rolly46/rust/playdate-wall-mount/playdate_flush_dock.3mf

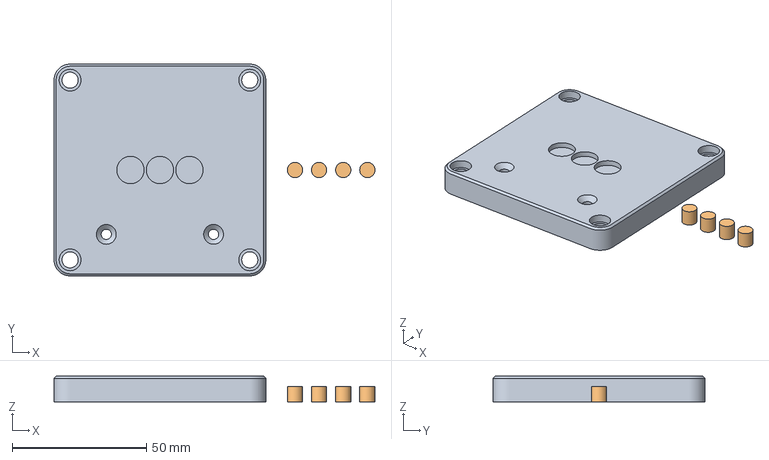
[picture p2: CAD file, 2026-10-04]
playdate-wall-mount/playdate_flush_dock.3mf
119.7 x 79.0 x 9.60 mm
Playdate wall dock plate
Contact pins
