rolly46/rust/playdate-wall-mount/playdate_contact_pins.stl

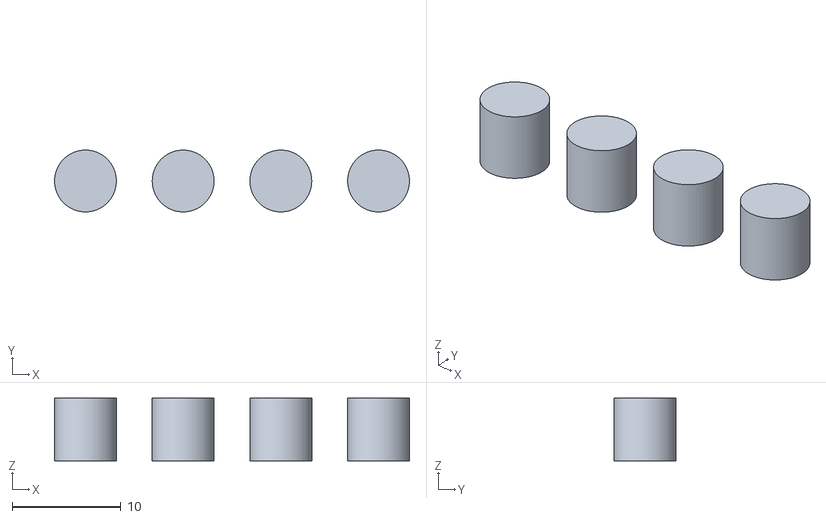
[picture p3: CAD file, 2026-10-04]
playdate-wall-mount/playdate_contact_pins.stl
32.7 x 5.70 x 5.80
