rolly46/rust/(list of files, cad)

Other CAD files:
playdate-wall-mount/playdate_flush_dock.stl
