rolly46/rust/(commit log)

2026-10-03 Add wall bracket for the Playdate magnetic charging dock
    Parametric OpenSCAD part that replaces the angled desk foot of MakerWorld
    model 1635754 so the dock hangs on a wall. It reuses the dock's alignment
    pegs and cable nut, routes the cable down through the bracket, hangs on two
    keyhole screws, and adds an optional ledge to catch the Playdate.
    Claude-Session: https://claude.ai/code/session_018FJy8db1WNSYvoHae4cP46
    [playdate_wall_bracket.scad, playdate_wall_bracket.stl]
2026-10-03 Drop the ledge from the Playdate wall bracket by default
    The bracket now sits flush behind the dock with nothing sticking out at
    the bottom. The ledge is still available with ledge = true.
    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
    [playdate_wall_bracket.scad, playdate_wall_bracket.stl]
2026-10-04 Replace the wall bracket with a flush one-piece dock plate
    The dock is now a single 4.4 mm plate that screws flat to the wall. Four
    8 x 3 mm magnets sit flush in the front; the USB cable comes through a
    hole in the wall behind the centre, and its power wires run in grooves on
    the flat back to the magnets, clamped there when the plate is screwed
    down. Two countersunk screws, hidden by the docked Playdate, hold it.
    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
    [playdate_flush_dock.scad, playdate_flush_dock.stl, playdate_wall_bracket.scad, playdate_wall_bracket.stl]
2026-10-04 Add a USB-C board compartment to the flush Playdate dock
    The back of the plate now has a bay for a USB-C 5 V breakout board and a
    channel for the cable's plug, which lies flat against the wall with the
    cable turning into the wall hole at the centre. The plate grows to 8.2 mm
    to fit the plug. Printed contact pins press the wires onto the magnets.
    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
    [playdate_contact_pins.stl, playdate_flush_dock.scad, playdate_flush_dock.stl]
2026-10-04 Enlarge the USB-C board bay in the flush Playdate dock to 22 x 20 mm
    The bay now takes nearly any USB-C 5 V breakout board, and the README
    says which board to buy and why the CC resistors matter.
    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
    [playdate_flush_dock.scad, playdate_flush_dock.stl]
2026-10-04 Hedge the Adafruit board fit note in the Playdate dock README
    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
2026-10-04 Add three centred 15 mm holding magnets to the flush Playdate dock
    Like the Minimalist Playdate Stand, three larger magnets near the middle
    of the Playdate's back now do most of the holding: two either side of the
    plug channel and one below it. The wall screws move down to make room.
    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
    [playdate_flush_dock.scad, playdate_flush_dock.stl]
2026-10-04 Put the Playdate dock's holding magnets over the steel strip
    A photo of the inside of the Playdate's back cover shows a steel strip
    about 35 x 10 mm at the centre. Three 10 x 2 mm magnets now sit in a row
    right over it, in front of the plug channel; the plate grows to 9.6 mm.
    The corner hole spacing estimate moves to 67 x 67 mm and the plate to
    79 x 79 mm to keep the corner magnets inside it.
    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
    [playdate_contact_pins.stl, playdate_flush_dock.scad, playdate_flush_dock.stl]
2026-10-04 Add a print-ready 3MF of the Playdate dock plate and contact pins
    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
    [playdate_flush_dock.3mf]
